saoneill01-a11y/ha-dip/case/out/preview_esp_lip_section.png

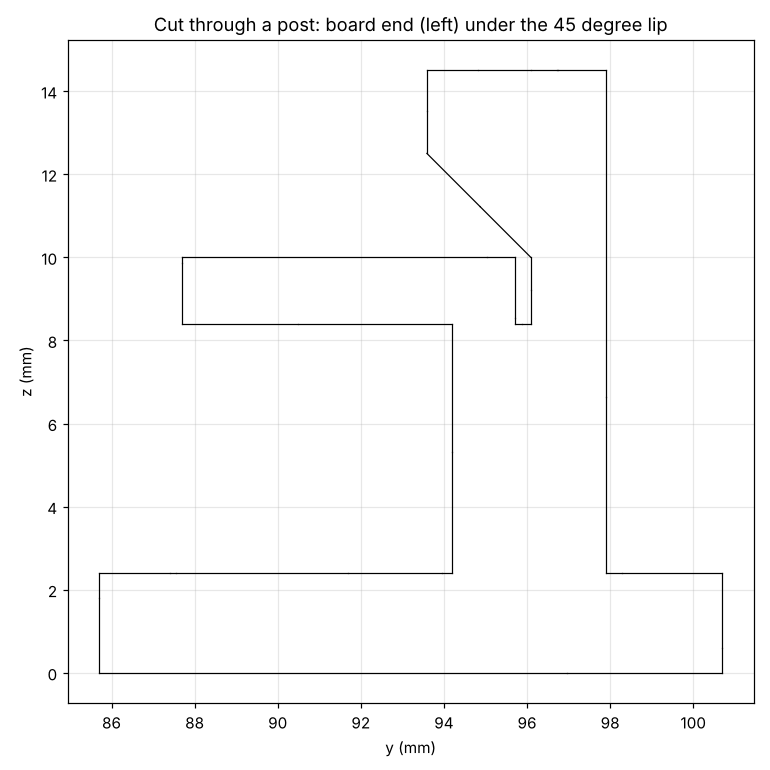
case/out/preview_esp_lip_section.png
