saoneill01-a11y/ha-dip/case/out/preview_esp_mount.png

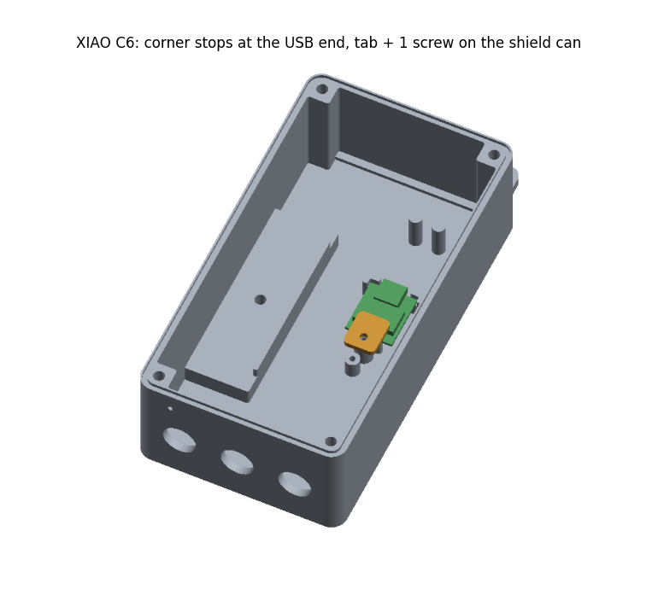
case/out/preview_esp_mount.png
