saoneill01-a11y/ha-dip/case/out/preview_float_bracket.png

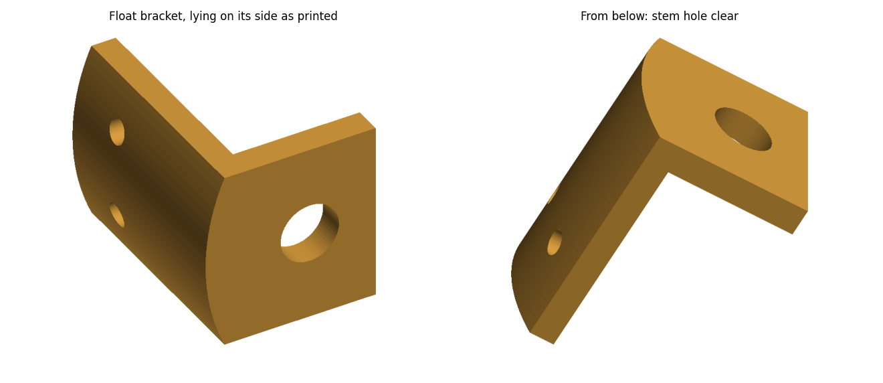
case/out/preview_float_bracket.png
