saoneill01-a11y/ha-dip/case/out/preview_glands_v03.png

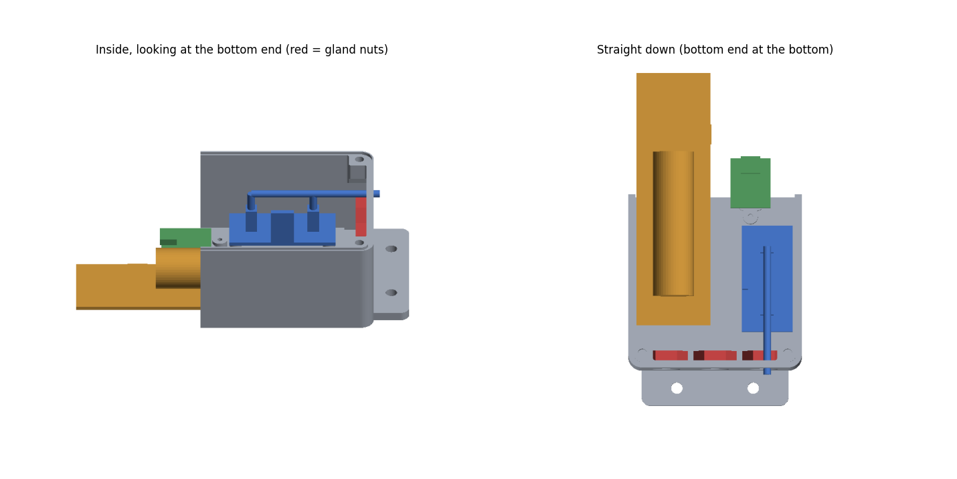
case/out/preview_glands_v03.png
