saoneill01-a11y/ha-dip/case/out/preview_lid.png

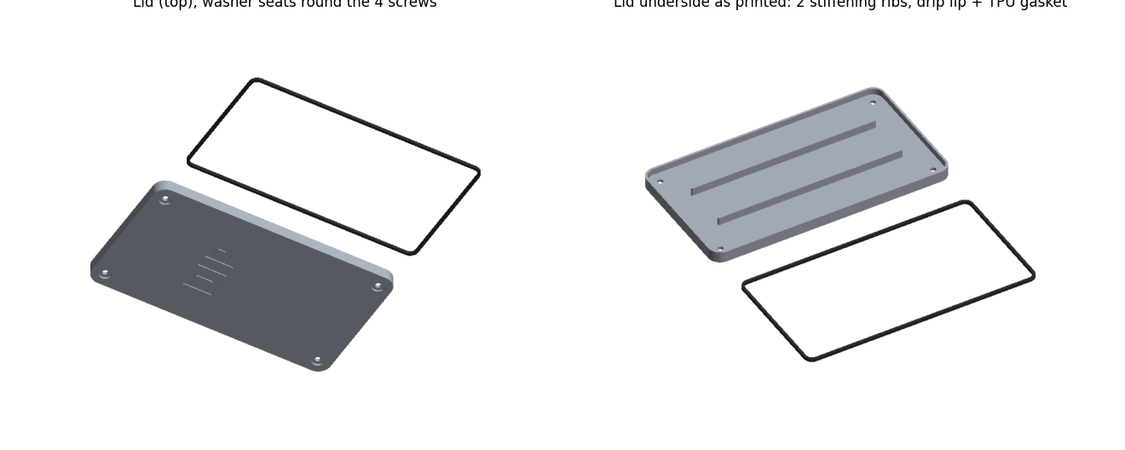
case/out/preview_lid.png
