saoneill01-a11y/ha-dip/case/out/preview_pipe.png

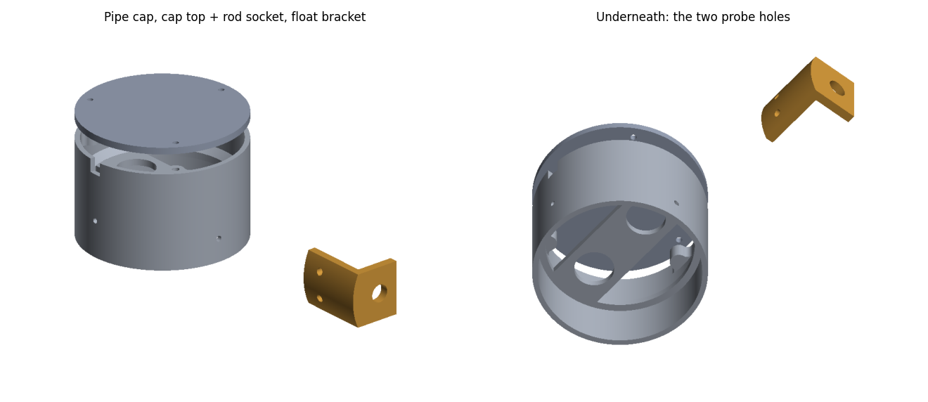
case/out/preview_pipe.png
