saoneill01-a11y/ha-dip/case/out/preview_pipe_cap_chamfer.png

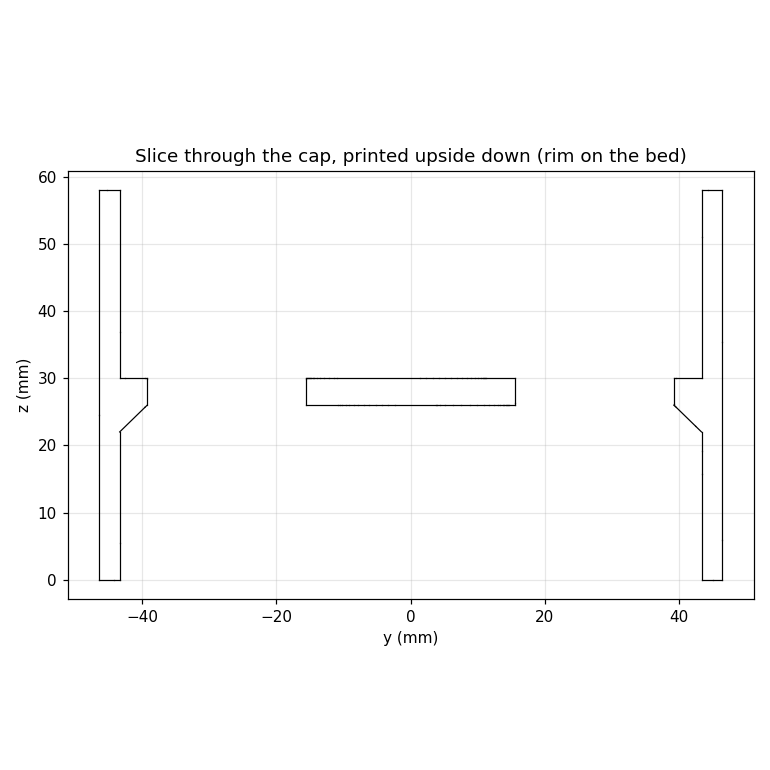
case/out/preview_pipe_cap_chamfer.png
