saoneill01-a11y/ha-dip/case/out/preview_pipe_cap_posts.png

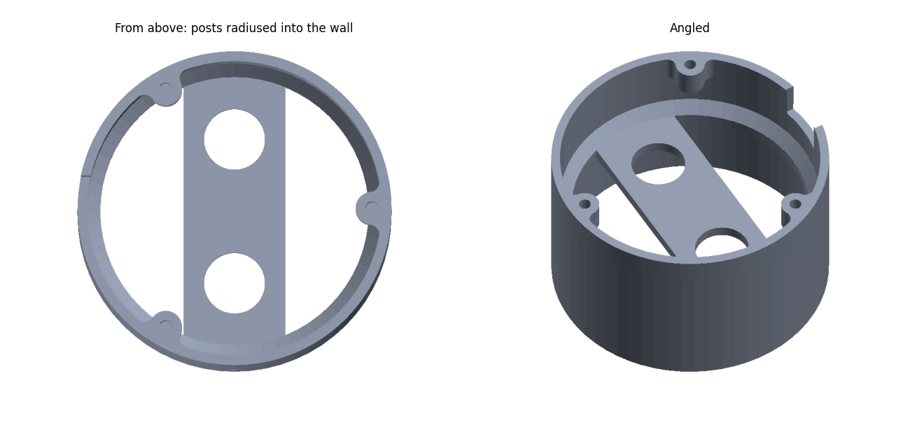
case/out/preview_pipe_cap_posts.png
