saoneill01-a11y/ha-dip/case/out/preview_pipe_cap_top.png

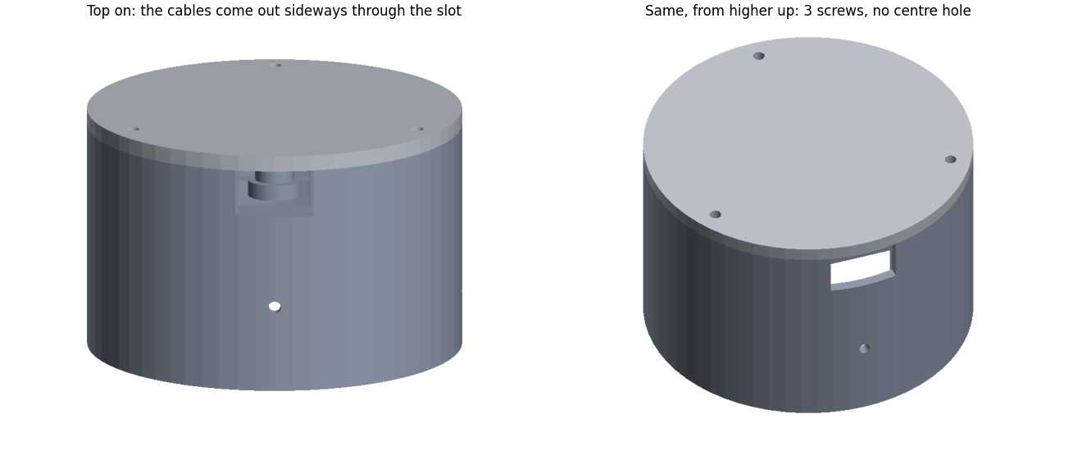
case/out/preview_pipe_cap_top.png
