saoneill01-a11y/ha-dip/case/out/preview_standoffs.png

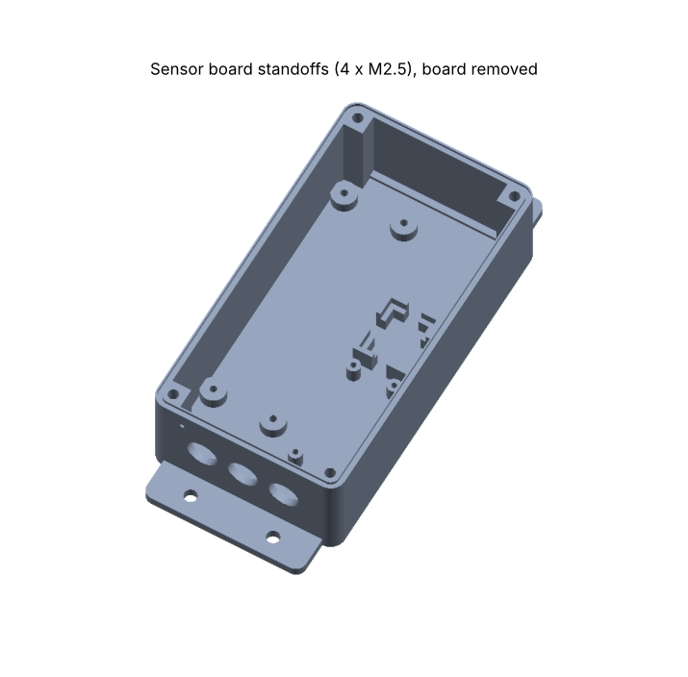
case/out/preview_standoffs.png
