saoneill01-a11y/ha-dip/case/out/box.stl

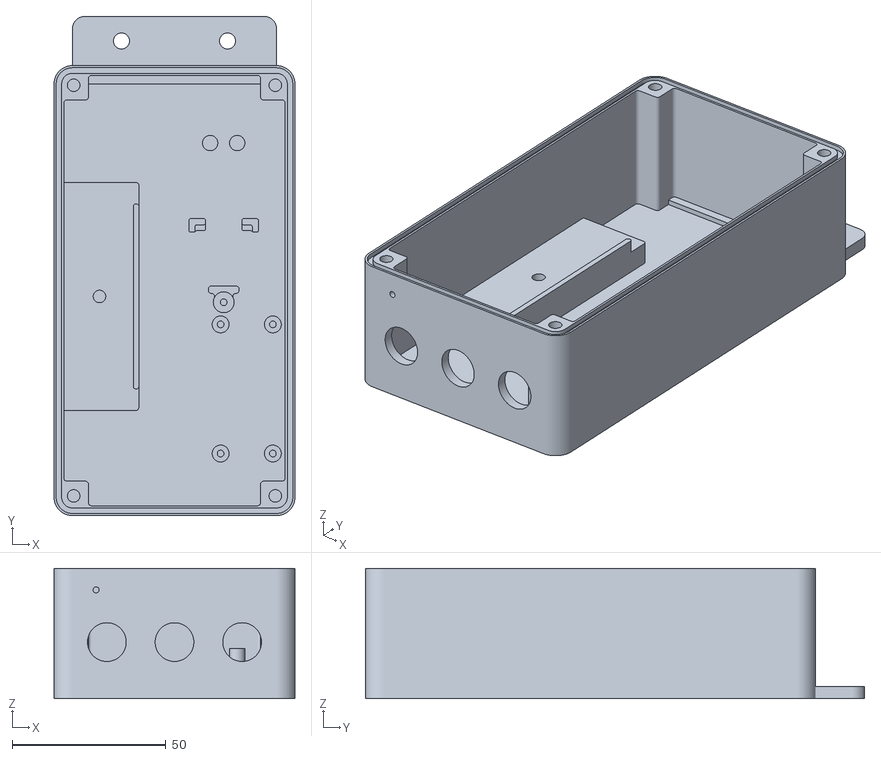
[picture p16: CAD file, 2026-11-01]
case/out/box.stl
78.4 x 162.4 x 42.4
