saoneill01-a11y/ha-dip/case/out/float_bracket_outside.stl

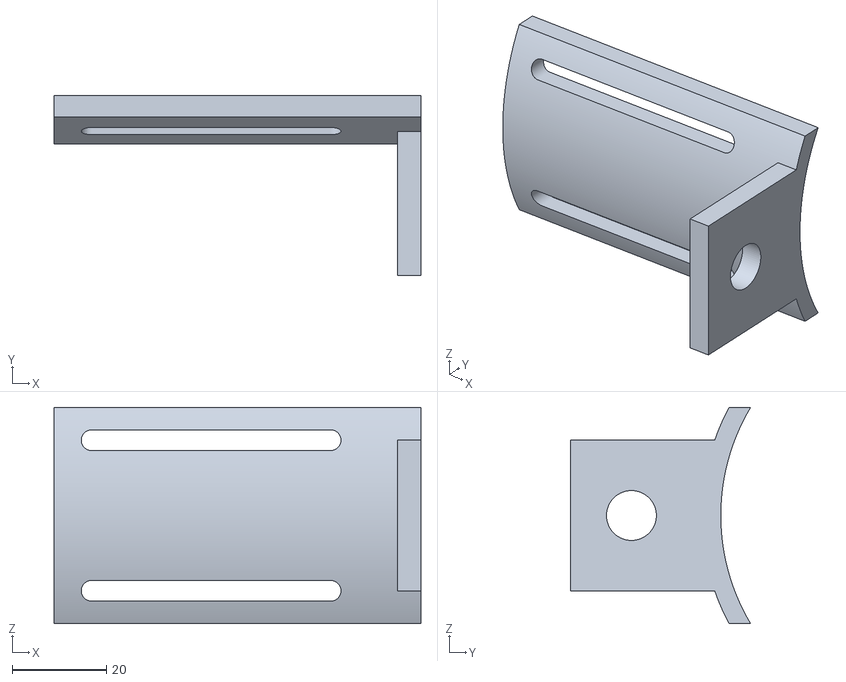
[picture p17: CAD file, 2026-11-01]
case/out/float_bracket_outside.stl
78.0 x 38.4 x 46.0
