saoneill01-a11y/ha-dip/case/out/esp_clamp.stl

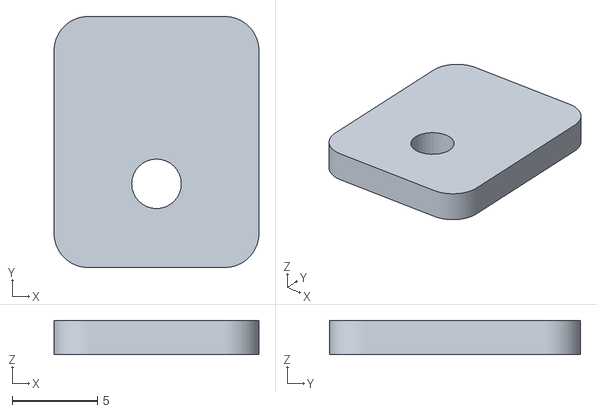
[picture p18: CAD file, 2026-11-01]
case/out/esp_clamp.stl
12.0 x 14.7 x 2.00
