saoneill01-a11y/ha-dip/case/out/pipe_cap.stl

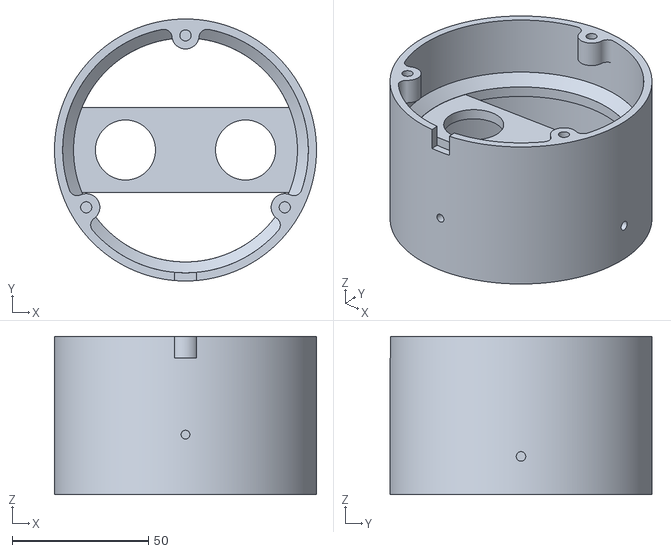
[picture p19: CAD file, 2026-10-28]
case/out/pipe_cap.stl
96.0 x 96.0 x 58.0
