saoneill01-a11y/ha-dip/case/out/float_bracket.stl

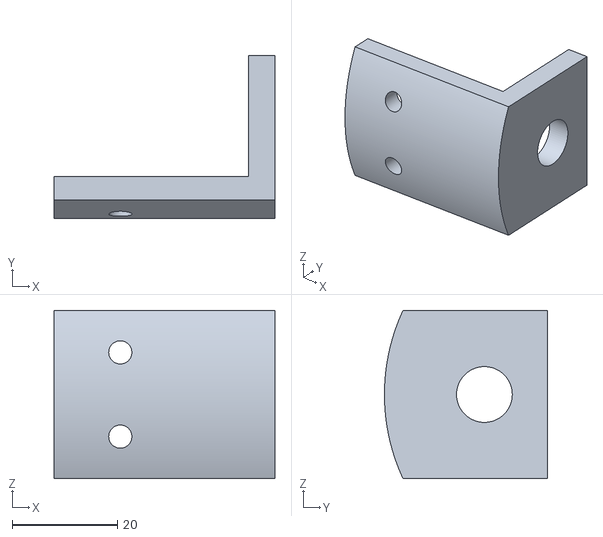
[picture p20: CAD file, 2026-10-28]
case/out/float_bracket.stl
42.0 x 31.0 x 32.0
