saoneill01-a11y/ha-dip/case/out/pipe_cap_top.stl

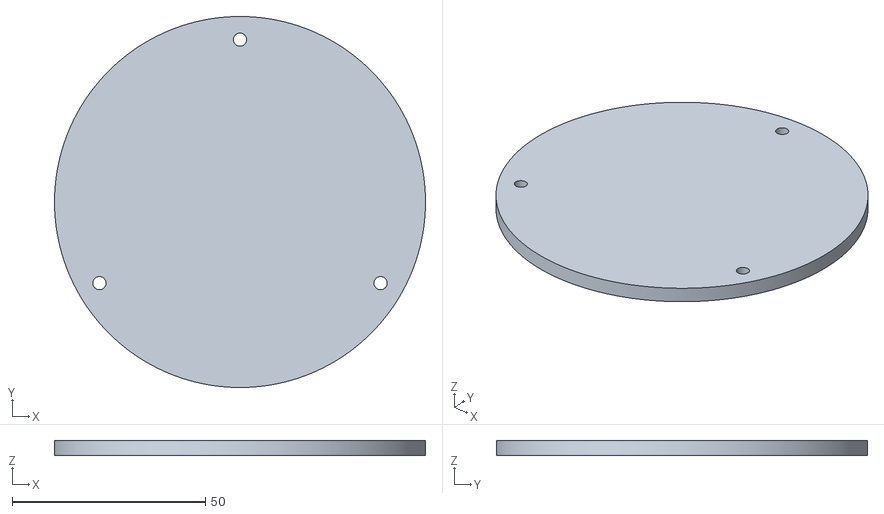
[picture p21: CAD file, 2026-10-28]
case/out/pipe_cap_top.stl
96.0 x 96.0 x 4.00
