saoneill01-a11y/ha-dip/case/out/box_lid.stl

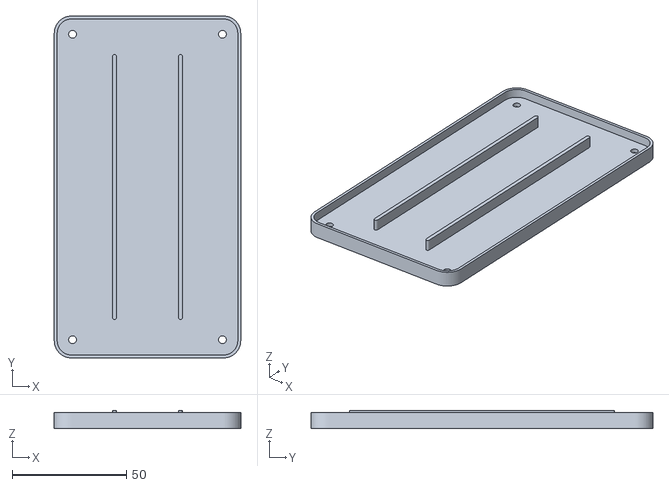
[picture p22: CAD file, 2026-10-25]
case/out/box_lid.stl
81.6 x 149.6 x 8.00
