saoneill01-a11y/ha-dip/case/out/gasket.stl

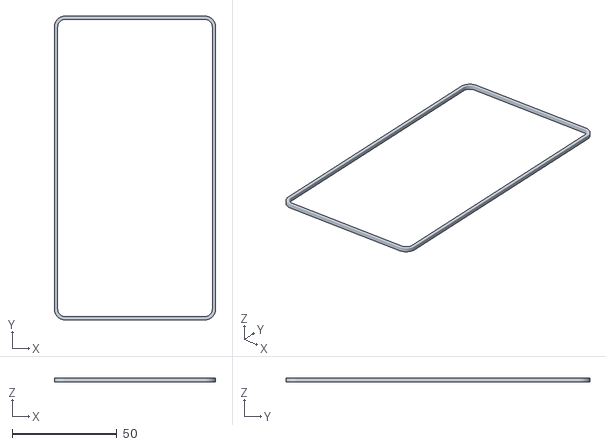
[picture p23: CAD file, 2026-10-25]
case/out/gasket.stl
76.8 x 144.8 x 1.90
