saoneill01-a11y/ha-dip/docs/guide/d_boxend.png

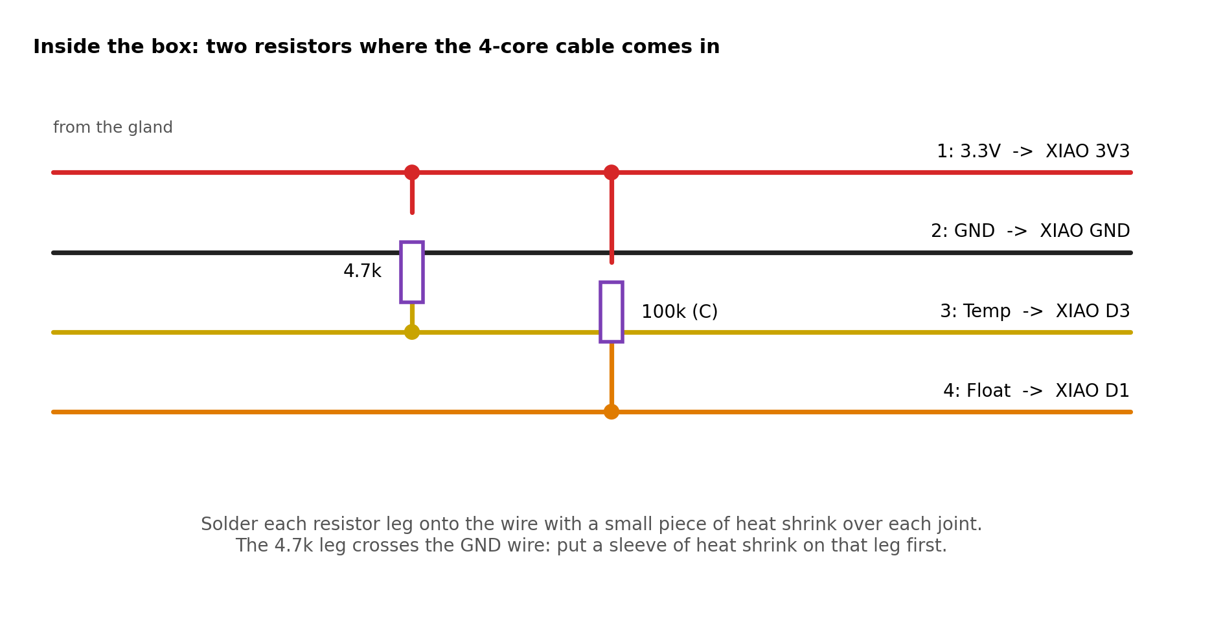
docs/guide/d_boxend.png
