saoneill01-a11y/ha-dip/docs/guide/d_coax.png

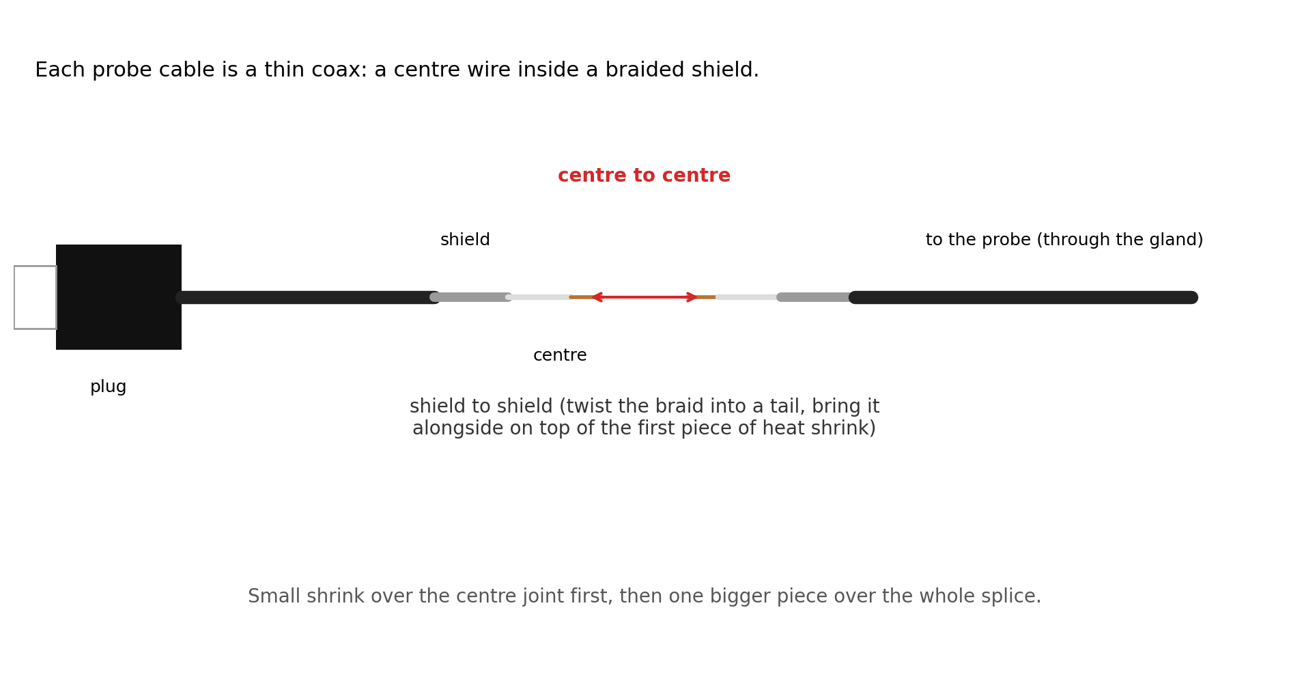
docs/guide/d_coax.png
