saoneill01-a11y/ha-dip/docs/guide/holder_back.jpg

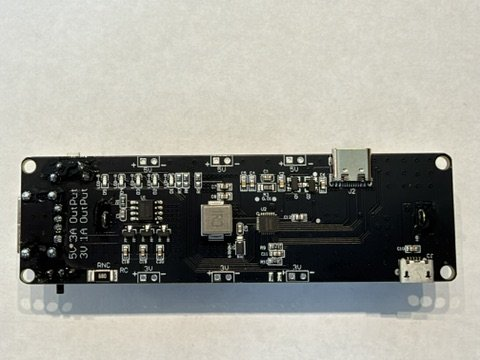
docs/guide/holder_back.jpg
