saoneill01-a11y/ha-dip/docs/guide/holder_top_a.jpg

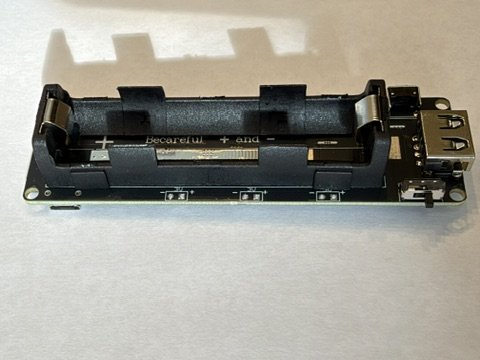
docs/guide/holder_top_a.jpg
