saoneill01-a11y/ha-dip/docs/guide/holder_top_b.jpg

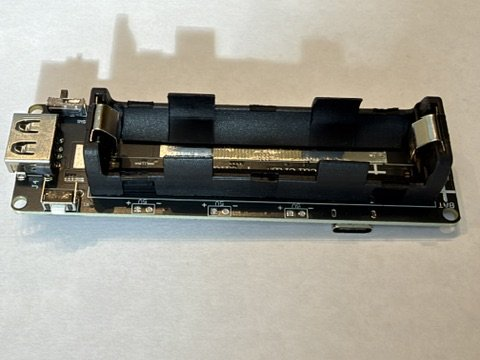
docs/guide/holder_top_b.jpg
