saoneill01-a11y/ha-dip/docs/guide/supermini_back.jpg

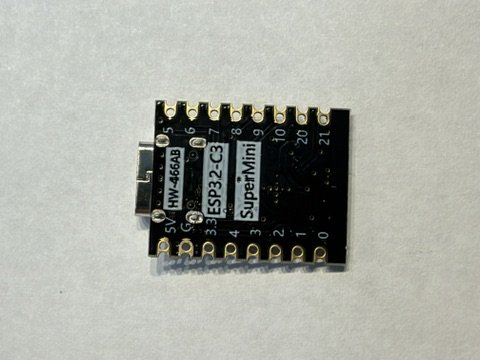
docs/guide/supermini_back.jpg
