saoneill01-a11y/ha-dip/docs/guide/supermini_front.jpg

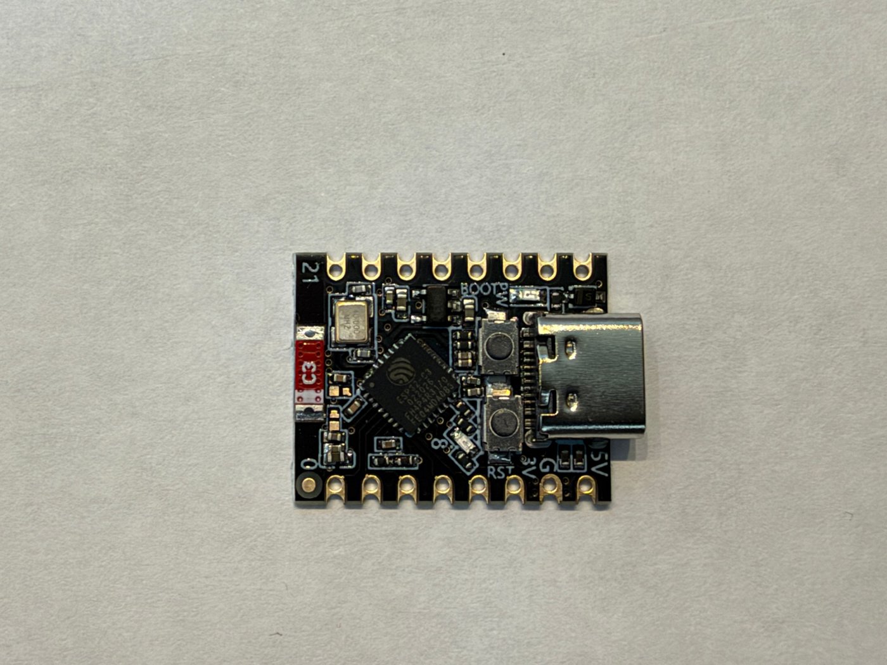
docs/guide/supermini_front.jpg
