saoneill01-a11y/ha-dip/(commit log)

2026-10-25 Pond sensor: printed parts draft v0.1
    Electronics box (BLIPR battery-holder mount, cradles, glands, gasket lid),
    pipe cap with probe holes and rod socket, float bracket, previews, README.
    Claude-Session: https://claude.ai/code/session_01NvhcrT1TvtWTS87yL8V47c
    [box.stl, box_lid.stl, float_bracket.stl, pipe_cap.stl, pipe_cap_top.stl]
2026-10-25 Box stands upright: glands in the short bottom end, no charge or button holes
    Holder up the left side with its USB-C port facing in (room for a plug with the
    lid off); boards stacked beside it; 6 lid screws; post ears top and bottom.
    Box is now about 78 x 146 x 36 mm (was 192 x 74).
    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
    [box.stl, box_lid.stl]
2026-10-25 Printable TPU gasket for the box lid; flat lid presses it
    Gasket 1.6 x 1.9 mm in the 1.8 x 1.4 rim groove, 0.5 mm proud (about 25 %
    squeeze). Lid tongue removed. README: PG7 glands seal the cable holes.
    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
    [box_lid.stl, gasket.stl]
2026-10-25 Notes: box has no port/button holes; keep plug clearance
    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
2026-10-25 ESPHome firmware, Home Assistant package and wiring picture
    Deep sleep every 20 min (2 min while the float is low), float switch on GPIO3 as an
    instant wake pin, median of 5 ultrasonic readings, battery %, stay-awake switch.
    HA package: level below full, low-water critical alert + pumps off/on, quiet-sensor
    and low-battery alerts. Test-compiled with ESPHome 2026.10.0.
    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
2026-10-25 Add a DS18B20 pond water-temperature probe
    GPIO5 with a 4.7k pull-up, read on each wake. Float and probe share one 4-core cable
    from the box to the pipe cap; new cable hole in the cap plate. Wiring picture,
    parts and pin table updated. Test-compiled with ESPHome 2026.10.0.
    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
    [pipe_cap.stl]
2026-10-25 Parts: temperature probe ordered
    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
2026-10-25 Name it DIP (Depth In Pond)
    firmware/pond-sensor.yaml -> firmware/dip.yaml (device name dip, shows as DIP in HA),
    ha/pond_package.yaml -> ha/dip_package.yaml with sensor.dip_* entity IDs and the
    DIP stay awake helper; README, notes, case and wiring titles updated.
    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
2026-10-25 Lid: DIP lettering in BLIPR's rounded block letters
    18 mm tall, stroke scaled from BLIPR's 12 mm / 2.4 mm, cut 0.6 mm into the lid's front
    face (on the bed side, so it prints crisp). New preview: preview_front.png.
    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
    [box.stl, box_lid.stl, float_bracket.stl, gasket.stl, pipe_cap.stl, pipe_cap_top.stl]
2026-10-25 Lid: four corner screws only, two stiffening ribs underneath
    The top-middle and right-side screws are gone; ribs (1.8 x 5 mm, running up the box)
    keep the lid flat so the gasket is squeezed evenly by the corner screws.
    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
    [box.stl, box_lid.stl]
2026-10-25 Box 6 mm deeper for the sensor board's plugs
    The JST probe plugs and the 4 jumper wires stand straight up off the board's connector
    side (toward the lid). Inside depth 34 -> 40 mm leaves 30 mm above the board, 25 mm
    under a lid rib. Preview shows the plugs.
    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
    [box.stl]
2026-10-25 Sensor board screws down on 4 standoffs
    Replaces its cradle: 5.5 mm posts, 7 mm tall (clears the parts side), 2.2 mm pilots
    for M2.5 x 6 screws, holes 3 mm in from each corner of the 48 x 23 board.
    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
    [box.stl]
2026-10-25 Battery-holder pads 8 mm across (were 10)
    The 10 mm pads on BLIPR hit parts on the underside of the holder board. Same screw
    holes and height.
    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
    [box.stl]
2026-10-25 Battery-holder screw holes 2.9 mm (2.8 was too tight)
    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
    [box.stl]
2026-10-25 SuperMini: hook-and-screw mount instead of a drop-in cradle
    USB end slides under two corner lips (either side of the USB-C socket), the far end is
    held by a printed tab (esp_clamp.stl) with one M2.5 x 6 into a post. Board rests on its
    short ends so wires in the pin holes are clear. Sensor board moved 6 mm down to make room.
    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
    [box.stl, esp_clamp.stl]
2026-10-25 SuperMini posts: 2 mm lips, no sideways overhang
    Each USB-end post is now a plain corner (side + back wall) with a 2 mm thick lip that
    reaches 1.2 mm over the board's end from the back wall only, so it prints without
    supports. Zoomed preview: preview_esp_hooks.png.
    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
    [box.stl]
2026-10-25 SuperMini lips: 45-degree wedges, taller posts
    Each lip leaves the back wall at board-top height and slopes out and up at 45 degrees
    (2.5 mm out, 2 mm thick at the tip), so it prints without supports and catches the
    board's end edge with 0.4 mm of play. Posts rise to 14.5 mm. Cut-through picture:
    preview_esp_lip_section.png.
    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
    [box.stl]
2026-10-25 Round every upright corner (1 mm) on posts, columns, rests and rib ends
    ESP posts (walls now 2.4 mm), the rests under the ESP, the four lid-screw columns
    (rounded and filleted into the walls) and the lid ribs' ends. STLs now come out
    watertight: write_stl merges near-duplicate points and drops zero-area slivers.
    Notes: Sean's printing rules (no square vertical corners, no supports).
    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
    [box.stl, box_lid.stl, float_bracket.stl, pipe_cap_top.stl]
2026-10-27 Float bracket: no brace through the stem hole; STL lies on its side to print
    [float_bracket.stl]
2026-10-27 Pipe cap top: flat underside, no locating ridge (the 3 screws locate it)
    [pipe_cap_top.stl]
2026-10-27 Pipe cap: screw posts set into the wall, full height to the rim
    [pipe_cap.stl, pipe_cap_top.stl]
2026-10-28 Pipe cap: 90 mm bore for the measured 89 mm pipe; plate opened either side of the probes
    Float bracket back follows the measured 76 mm pipe ID.
    [float_bracket.stl, pipe_cap.stl, pipe_cap_top.stl]
2026-10-28 Pipe cap: no drop rod; cables leave sideways through a slot in the rim, flat top, lock screw
    The pipe stands in a cinder block with pea gravel, so it needs no rod. The cap top is a plain
    flat lid. Cap-top screw positions no longer depend on the cap being built first.
    [pipe_cap.stl, pipe_cap_top.stl]
2026-10-28 Pipe cap: 45-degree chamfer under the ledge so it prints upside down without supports there
    [pipe_cap.stl]
2026-10-28 Pipe cap: short screw posts hanging from the rim, no base patches (prints upside down unsupported)
    [pipe_cap.stl]
2026-10-28 Pipe cap: 3 mm radius where the screw posts meet the wall
    [pipe_cap.stl]
2026-10-28 Pipe cap: cable slot cuts clean through the curved wall (no leftover lip at its sides)
    [pipe_cap.stl]
2026-10-28 Smoother rounds: big circles get enough sides that none is longer than about 0.5 mm
    [box.stl, float_bracket.stl, pipe_cap.stl, pipe_cap_top.stl]
2026-10-28 Pipe cap: probe band's underside (as printed) stepped 0.1 mm off the ledge so supports paint on the band alone
    [pipe_cap.stl]
2026-10-28 Pipe cap: fix non-manifold edges (screw-post outline no longer shares the wall's outer face)
    [pipe_cap.stl]
2026-10-28 Pipe cap: 22 mm probe holes for the measured 21.5 mm probes
    [pipe_cap.stl]
2026-10-28 Pipe cap: 8 x 8 mm cable slot
    [pipe_cap.stl]
2026-10-28 README: JSN-SR20-Y3.0 board, no MODE resistor, 3V3 bench test, cable wiring
2026-10-28 Assembly guide (Word) with photos, part renders and wiring diagrams
    Sensor powered from holder 3V pair 2, 4-core cable from pair 3 with the pull-ups at its box end.
2026-10-31 Firmware: distance device_class and long-term stats for distance and battery
2026-10-31 Firmware: battery voltage calibrated against a meter; 4.08 V = full
2026-10-31 Case v0.3: glands 22 mm apart and 4 mm lower, short bottom lid posts with 45-degree undersides, sensor board 7 mm right and 2 mm up
    [box.stl]
2026-10-31 Case v0.3: drop the bottom mounting ear (the glands block its screws); the two top screws hold the box
    [box.stl]
2026-10-31 Docs for a public release: README rewritten, assembly guide brought up to date (v0.3 box, top-tab mounting, stay-awake, calibration, float test), generic HA package matching the pump shutoff in use
2026-10-31 MIT license; remove personal references from notes, case comments and previews
2026-10-31 Assembly guide as PDF; README links it
2026-11-01 v0.4: XIAO ESP32-C6 and a plain 18650 holder
    The battery shield's always-on 5V booster emptied a full cell in about a day.
    The XIAO charges the cell itself and sleeps at microamps. New pins, battery
    platform, XIAO mount and USB-C cable clip; guide, diagrams and PDF updated.
    [box.stl, esp_clamp.stl]
2026-11-01 Box: battery platform fills to the side wall and the rail (no thin slots)
    [box.stl]
2026-11-01 Box: the short lid posts' 45-degree cut no longer goes into the floor
    [box.stl]
2026-11-01 Outside float bracket with 2-inch height slots
    [float_bracket_outside.stl]
2026-11-01 Box: round inside corners at the bottom end again (the lid-post cut had squared them)
    [box.stl]
2026-11-01 STLs: fix non-manifold edges (box and pipe cap)
    Merge points that round to the same 32-bit value and drop only collapsed
    triangles; keep the corner cut 0.02 mm off the walls so no faces touch.
    [box.stl]
2026-11-03 Guide: fix the insert/screw count, outside bracket install, XIAO tips
2026-11-03 Case script: XIAO comments in place of the old SuperMini ones (no shape change)
2026-11-03 Power the distance sensor from D2 so it's off in deep sleep
    On 3V3 the JSN-SR20 drew ~2 mA while DIP slept (about 2 months per charge).
    Now D2 powers it only while awake; measured sleep current 0.03 mA.
2026-11-03 Wake every 30 minutes instead of 20 (longer battery life)
